jlaustill/gdh-electric/modules/crd-mcp2562/v0.0.1/Picture.png

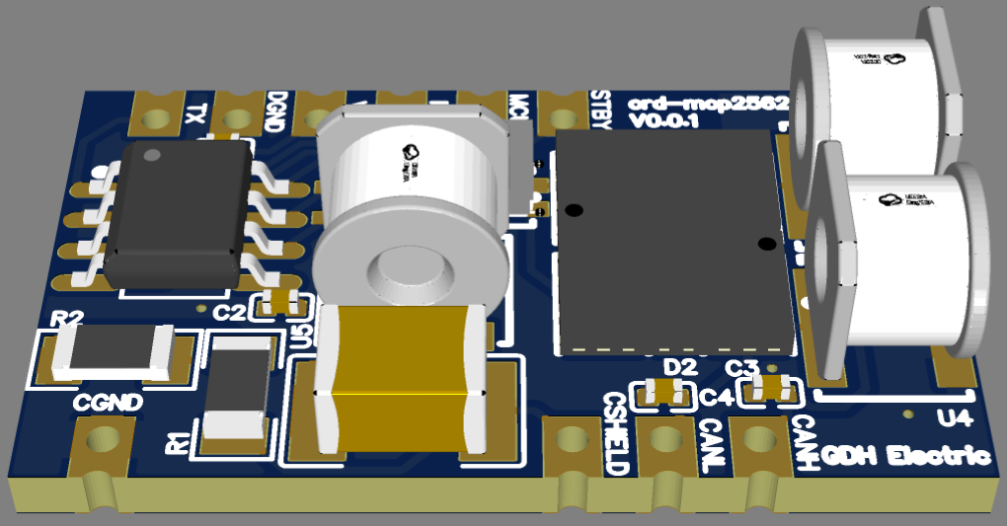
modules/crd-mcp2562/v0.0.1/Picture.png
