jlaustill/gdh-electric/modules/crd-mcp2562/v0.0.1/Schematic.pdf

# CAN-BUS

### CGND

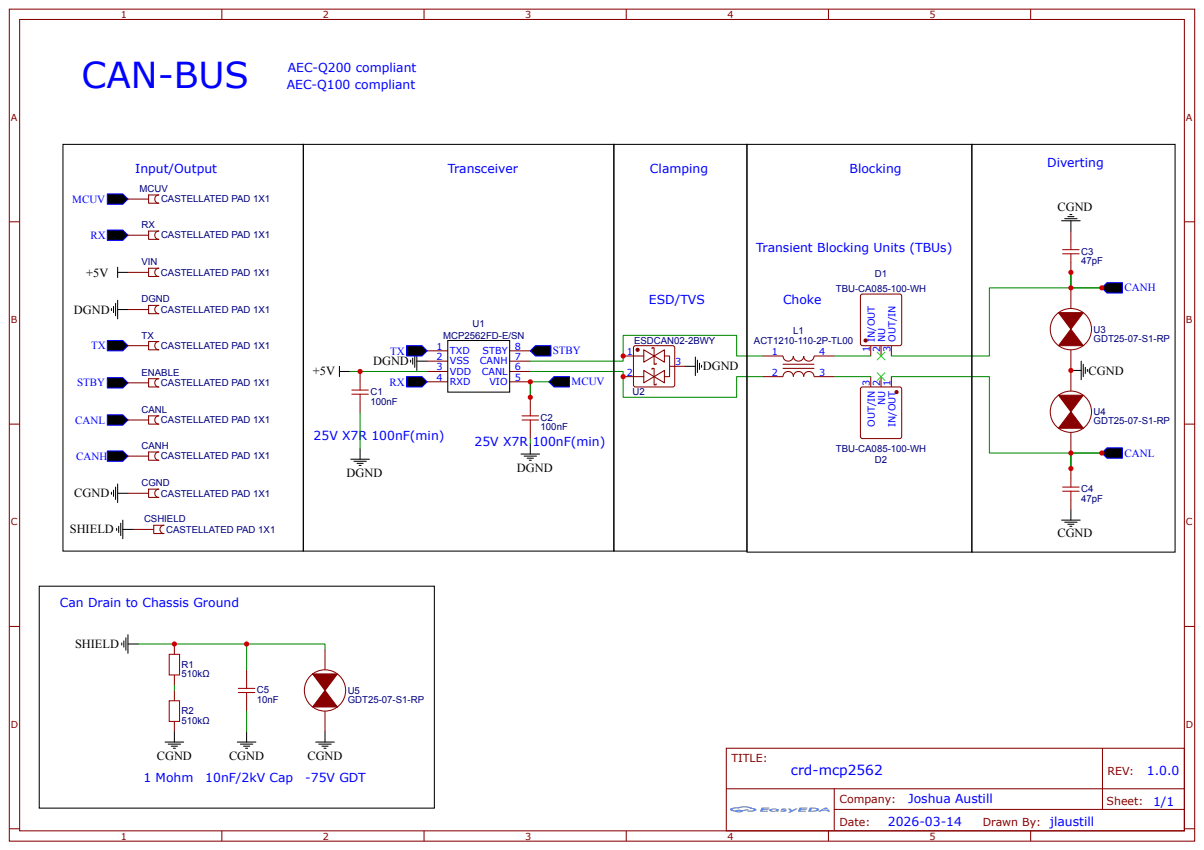
[picture p2: page 1]

Transient Blocking Units (TBUs)

IN/OUT 1 NU 2 OUT/IN 3

Can Drain to Chassis Ground
