jlaustill/gdh-electric/modules/mcu-stm32h725/v0.0.1/mcu-stm32h725.kicad_pcb

## KiCad design modules/mcu-stm32h725/v0.0.1/mcu-stm32h725.kicad_pcb (2026-06-19)

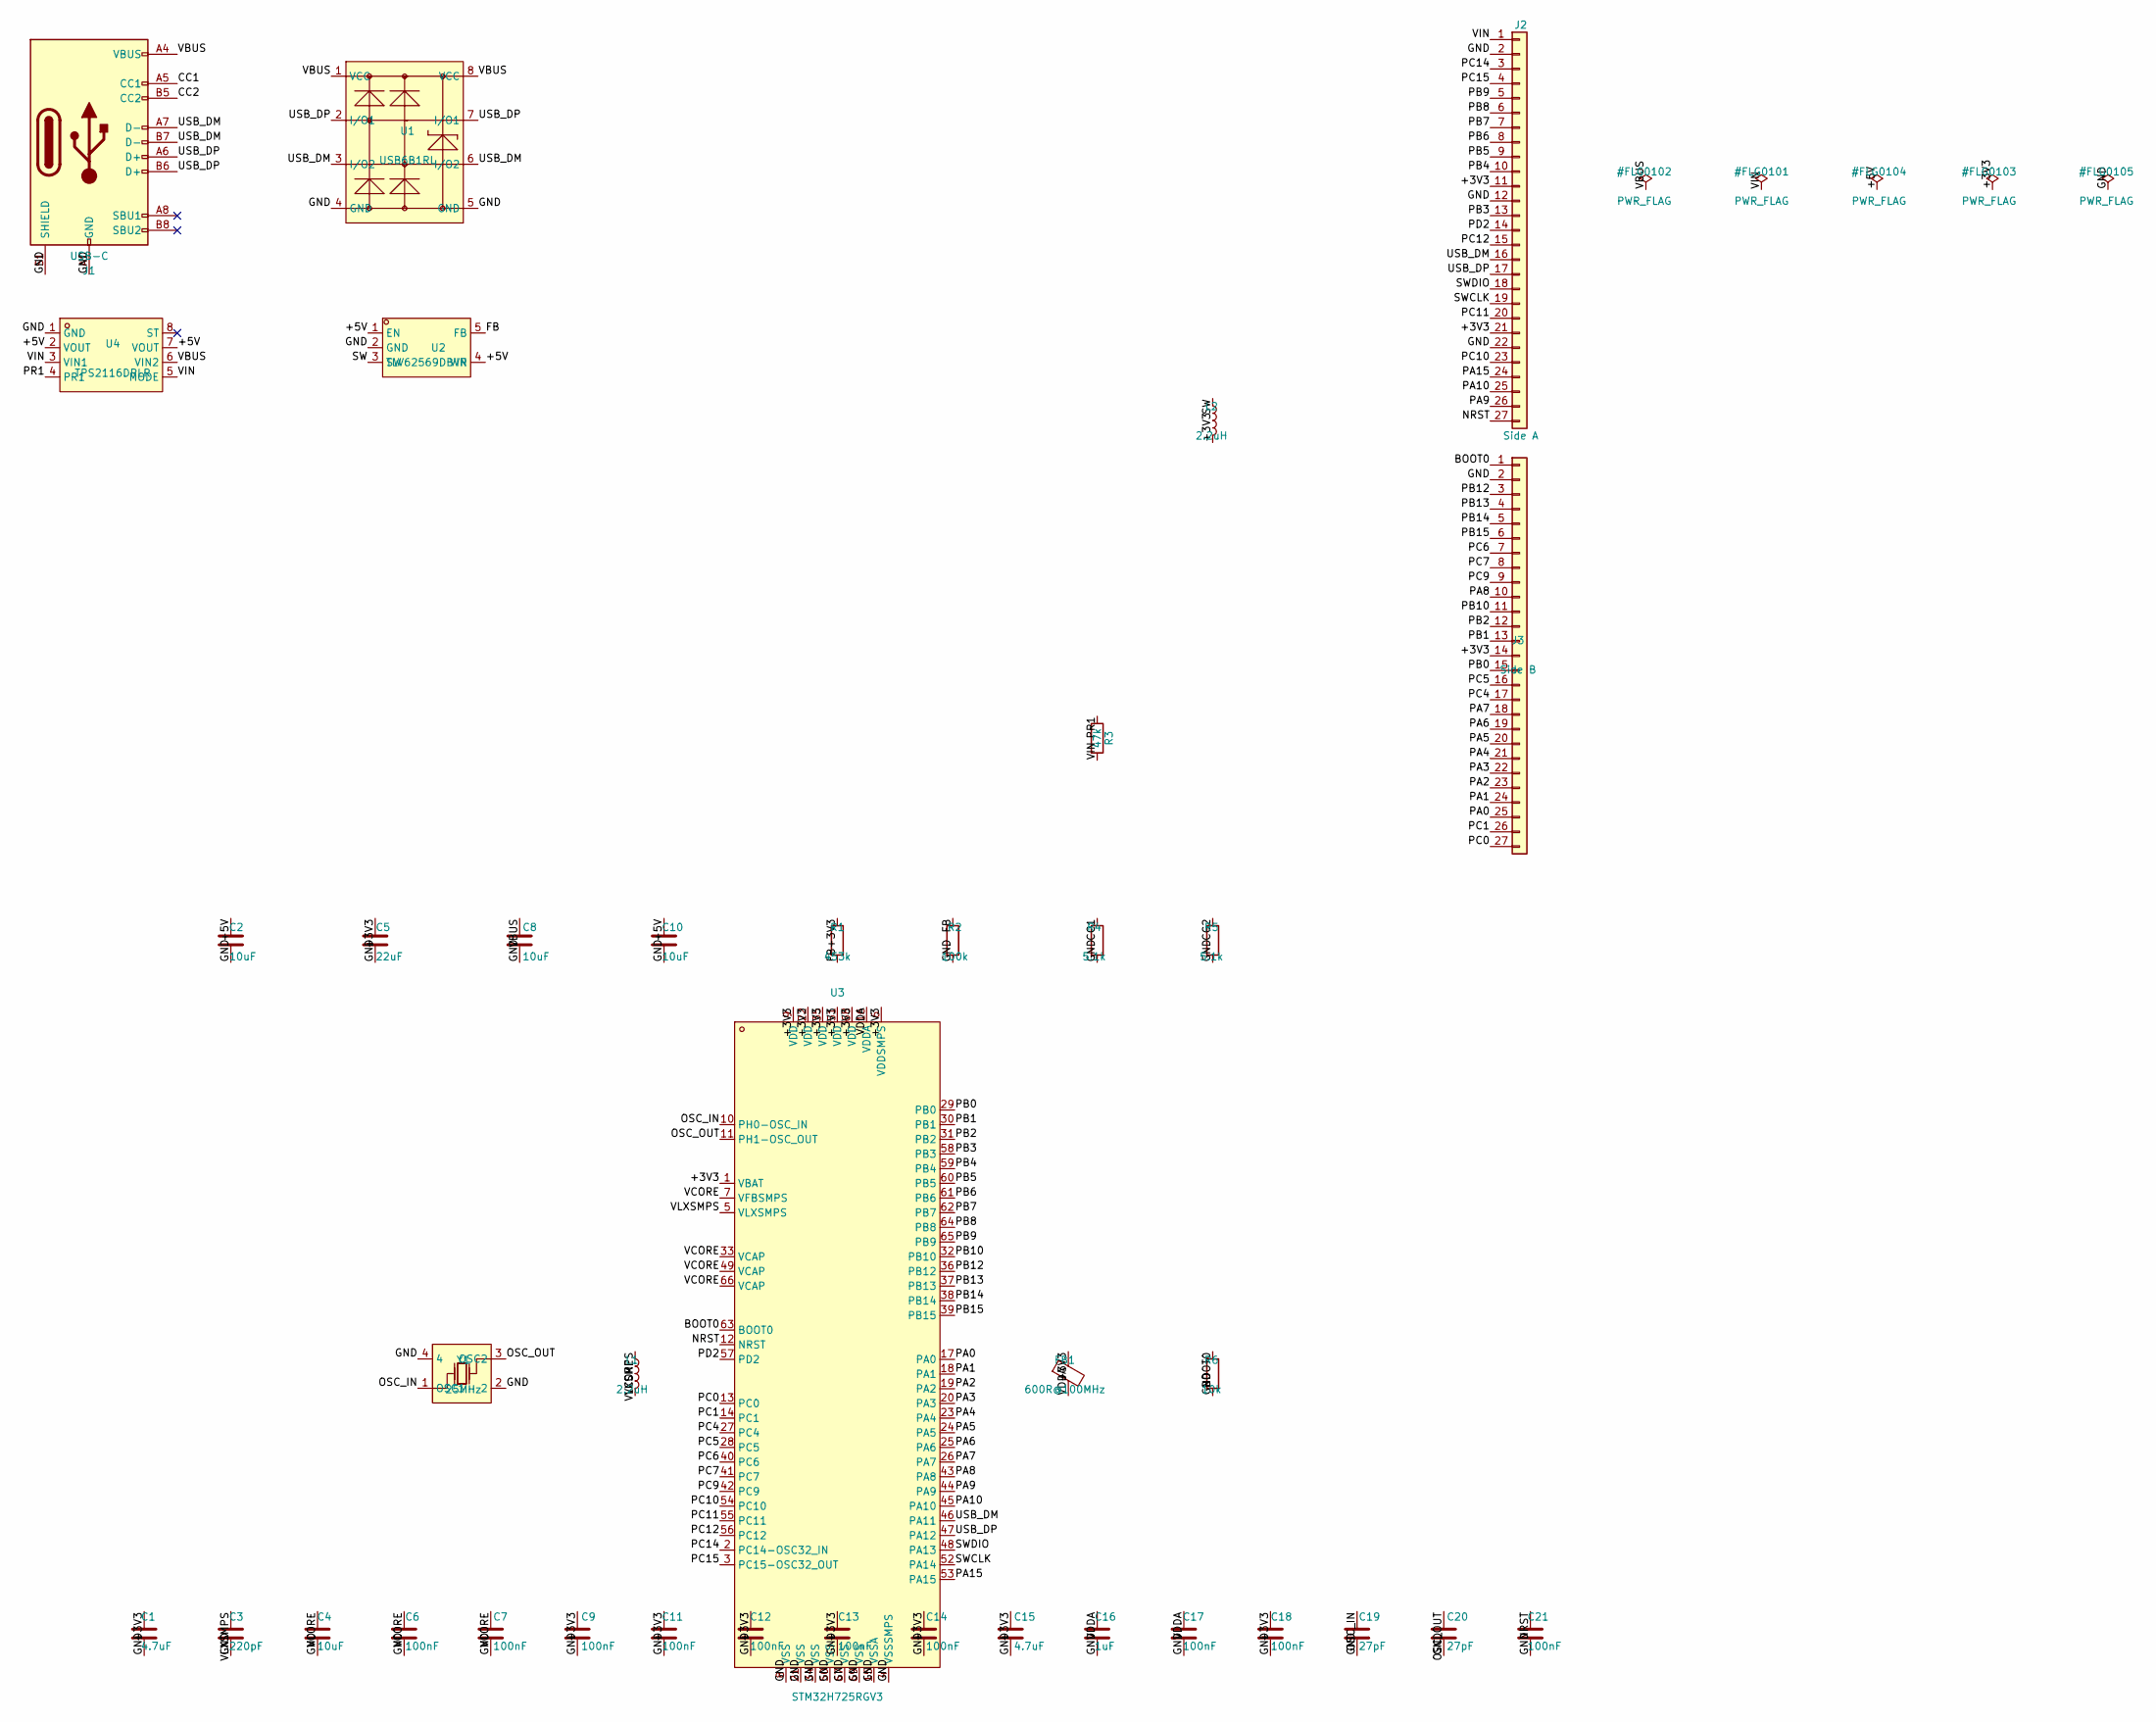
[picture p3: schematic mcu-stm32h725.kicad_sch]

Parts:
C1, C15: 4.7uF; C_0805_2012Metric
C2, C4, C8, C10: 10uF; C_0805_2012Metric
C3: 220pF; C_0402_1005Metric
C5: 22uF; C_0805_2012Metric
C6, C7, C9, C11, C12, C13, C14, C17, C18, C21: 100nF; C_0402_1005Metric
C16: 1uF; C_0805_2012Metric
C19, C20: 27pF; C_0402_1005Metric
FB1: 600R@100MHz; L_0805_2012Metric
J1: USB-C; USB-C_HYP_TC020-24LB02R_C23376530
J2: Side A; Castellation_1x27_P2.54mm_Edge
J3: Side B; Castellation_1x27_P2.54mm_Edge
L1, L2: 2.2uH; L_1210_3225Metric
R1: 453k; R_0603_1608Metric
R2: 100k; R_0603_1608Metric
R3: 47k; R_0603_1608Metric
R4, R5: 5.1k; R_0603_1608Metric
R6: 10k; R_0603_1608Metric
U1: USB6B1RL; SOIC-8_L4.9-W3.9-P1.27-LS6.0-BL
U2: TLV62569DBVR; SOT-23-5_L3.0-W1.7-P0.95-LS2.8-BR
U3: STM32H725RGV3; QFN-68_L8.0-W8.0-P0.40-BL-EP6.4
U4: TPS2116DRLR; SOT-583-8_L2.1-W1.6-P0.50-LS1.6-BL
Y1: 25MHz; CRYSTAL-SMD_4P-L3.2-W2.5-BL

Connections:
/+3V3: C1.1, C5.1, C9.1, C11.1, C12.1, C13.1, C14.1, C15.1, C18.1, FB1.1, J2.11, J2.21, J3.14, L2.2, R1.1, U3.1 (VBAT), U3.6 (VDDSMPS), U3.9 (VDD), U3.22 (VDD), U3.35 (VDD), U3.51 (VDD), U3.68 (VDD)
/+5V: C2.1, C10.1, U2.1 (EN), U2.4 (VIN), U4.2 (VOUT), U4.7 (VOUT)
/BOOT0: J3.1, R6.1, U3.63 (BOOT0)
/CC1: J1.A5 (CC1), R4.1
/CC2: J1.B5 (CC2), R5.1
/FB: R1.2, R2.1, U2.5 (FB)
/GND: C1.2, C2.2, C3.2, C4.2, C5.2, C6.2, C7.2, C8.2, C9.2, C10.2, C11.2, C12.2, C13.2, C14.2, C15.2, C16.2, C17.2, C18.2, C19.2, C20.2, C21.2, J1.A1 (GND), J1.A12 (GND), J1.B1 (GND), J1.B12 (GND), J1.S1 (SHIELD), J2.2, J2.12, J2.22, J3.2, R2.2, R4.2, R5.2, R6.2, U1.4 (GND), U1.5 (GND), U2.2 (GND), U3.4 (VSSSMPS), U3.8 (VSS), U3.15 (VSSA), U3.21 (VSS), U3.34 (VSS), U3.50 (VSS), U3.67 (VSS), U3.69 (VSS), U4.1 (GND), Y1.2, Y1.4
/NRST: C21.1, J2.27, U3.12 (NRST)
/OSC_IN: C19.1, U3.10 (PH0-OSC_IN), Y1.1 (OSC1)
/OSC_OUT: C20.1, U3.11 (PH1-OSC_OUT), Y1.3 (OSC2)
/PA0: J3.25, U3.17 (PA0)
/PA1: J3.24, U3.18 (PA1)
/PA2: J3.23, U3.19 (PA2)
/PA3: J3.22, U3.20 (PA3)
/PA4: J3.21, U3.23 (PA4)
/PA5: J3.20, U3.24 (PA5)
/PA6: J3.19, U3.25 (PA6)
/PA7: J3.18, U3.26 (PA7)
/PA8: J3.10, U3.43 (PA8)
/PA9: J2.26, U3.44 (PA9)
/PA10: J2.25, U3.45 (PA10)
/PA15: J2.24, U3.53 (PA15)
/PB0: J3.15, U3.29 (PB0)
/PB1: J3.13, U3.30 (PB1)
/PB2: J3.12, U3.31 (PB2)
/PB3: J2.13, U3.58 (PB3)
/PB4: J2.10, U3.59 (PB4)
/PB5: J2.9, U3.60 (PB5)
/PB6: J2.8, U3.61 (PB6)
/PB7: J2.7, U3.62 (PB7)
/PB8: J2.6, U3.64 (PB8)
/PB9: J2.5, U3.65 (PB9)
/PB10: J3.11, U3.32 (PB10)
/PB12: J3.3, U3.36 (PB12)
/PB13: J3.4, U3.37 (PB13)
/PB14: J3.5, U3.38 (PB14)
/PB15: J3.6, U3.39 (PB15)
/PC0: J3.27, U3.13 (PC0)
/PC1: J3.26, U3.14 (PC1)
/PC4: J3.17, U3.27 (PC4)
/PC5: J3.16, U3.28 (PC5)
/PC6: J3.7, U3.40 (PC6)
/PC7: J3.8, U3.41 (PC7)
/PC9: J3.9, U3.42 (PC9)
/PC10: J2.23, U3.54 (PC10)
/PC11: J2.20, U3.55 (PC11)
/PC12: J2.15, U3.56 (PC12)
/PC14: J2.3, U3.2 (PC14-OSC32_IN)
/PC15: J2.4, U3.3 (PC15-OSC32_OUT)
/PD2: J2.14, U3.57 (PD2)
/PR1: R3.1, U4.4 (PR1)
/SW: L2.1, U2.3 (SW)
/SWCLK: J2.19, U3.52 (PA14)
/SWDIO: J2.18, U3.48 (PA13)
/USB_DM: J1.A7 (D-), J1.B7 (D-), J2.16, U1.3 (I/O2), U1.6 (I/O2), U3.46 (PA11)
/USB_DP: J1.A6 (D+), J1.B6 (D+), J2.17, U1.2 (I/O1), U1.7 (I/O1), U3.47 (PA12)
/VBUS: C8.1, J1.A4 (VBUS), J1.A9 (VBUS), J1.B4 (VBUS), J1.B9 (VBUS), U1.1 (VCC), U1.8 (VCC), U4.6 (VIN2)
/VCORE: C4.1, C6.1, C7.1, L1.2, U3.7 (VFBSMPS), U3.33 (VCAP), U3.49 (VCAP), U3.66 (VCAP)
/VDDA: C16.1, C17.1, FB1.2, U3.16 (VDDA)
/VIN: J2.1, R3.2, U4.3 (VIN1), U4.5 (MODE)
/VLXSMPS: C3.1, L1.1, U3.5 (VLXSMPS)

Board: 4 copper layers, 38 parts (0 on the bottom side), 61 nets, no tracks yet.
