jlaustill/gdh-electric/(commit log)

2026-06-01 Add crd-mcp2562 module datasheets, clean BOM, and CC0 license
    - Clean BOM.csv: re-encode UTF-16 -> UTF-8, drop the castellated-pad
    footprint (not an orderable/placeable part), fill the TBU's empty
    Manufacturer Part field, and add a Datasheet column linking each
    part to its local PDF.
    - Add datasheets/ with all 9 orderable components (sourced from LCSC;
    the Kyocera AVX 47pF cap from Kyocera AVX directly).
    - Add CC0 1.0 Universal LICENSE (public-domain dedication).
    [BOM.csv, PickAndPlace.csv]
2026-06-01 Clean PickAndPlace.csv: re-encode UTF-8, drop castellated pads
    Re-encode UTF-16 -> UTF-8 and remove the 10 CASTELLATED_PAD rows, which
    are board-edge copper, not machine-placeable parts. Leaves the 15
    placeable components, consistent with the cleaned BOM.
    [PickAndPlace.csv]
2026-06-01 Add project CLAUDE.md with module/EasyEDA/datasheet workflow
    Captures the recurring conventions for this hardware module library:
    EasyEDA UTF-16 export handling, LCSC datasheet sourcing recipe, BOM/
    PickAndPlace conventions (exclude castellated pads), datasheet naming,
    and CC0 licensing default.
2026-06-01 Add GDH Electric module specification
    Establish spec/README.md as the living module standard, in two layers:
    - Philosophy: mission, right-to-repair/perpetuity, breadboard-compatible
    + reusability (castellated edges over 2.54mm pins to ease desoldering
    and reduce landfill waste), robust-by-default (-40C..125C minimum,
    AEC-Q200 parts), and the chip-driver-vs-MCU-peripheral library policy.
    - Conformance: module layout (version silkscreened on PCB), required
    deliverables, BOM/PnP/datasheet conventions, CC0 licensing, and
    reserved sections for future revisions.
    Remove the empty versioned v0.1.md stub; the spec is a living document
    with git as its changelog.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
2026-06-01 Switch crd-mcp2562 schematic to SVG; regenerate clean PDF
    EasyEDA's direct PDF export is low-fidelity (overlapping/mangled labels).
    Add Schematic.svg as the primary, browser-renderable, diff-friendly
    artifact and regenerate Schematic.pdf from it (crisp vector via cairo/
    inkscape). Updated schematic also fixes the GDT annotation (75 V) and
    adds clamp/block/divert functional blocks.
    - spec: required deliverables now list Schematic.svg (primary) +
    Schematic.pdf (generated from the SVG).
    - CLAUDE.md: document the SVG-export + convert-to-PDF workflow.
2026-06-01 Add crd-mcp2562 board images (top view + 3D render)
    - PCB-Top.svg: top-layer layout/silk view (added a dark background so the
    white silkscreen labels stay readable in GitHub light *and* dark mode).
    - Picture.png: 3D photo-realistic render; placeholder to be swapped for a
    real assembled-board photo later. Silk now reads STBY (pin renamed to
    match the schematic, not just the net label).
2026-06-03 Fold design doctrine into the spec
    Capture the design philosophy worked out in practice:
    - North star: design against the landfill (salvage in 50 years), explicitly
    rejecting minimum-viable/throwaway hardware.
    - Robust by default: protection is "silently omittable" so it must be baked
    in; litmus test — reject a design rule that would strip protection.
    - New "Module + carrier architecture" section: lean rugged core + stackable
    (ESP32-style) carriers; decide on-module vs carrier by "will a future
    integrator be forced to supply it, or is it silently omittable?"; cost
    rationale for keeping the core lean.
    - Seed the reserved "Electrical & protection minimums" with that rule.
    Co-Autho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
2026-06-03 Update CLAUDE.md with session learnings
    - Deliverables now lead with Schematic.svg (alongside the PDF).
    - Point to spec/README.md as the home for design doctrine + conformance.
    - Document the EasyEDA layout-SVG gotcha (transparent bg + white silk →
    invisible on GitHub light mode; inject a dark background rect).
    - Add a Board images section (Picture.png / PCB-Top.svg; 3D/STL dead-end).
2026-06-16 Add protect-12v module design spec (draft)
    Rugged 12V power-input protection front-end (Stage-1 lift of OCT); locked vs open decisions per spec/README.md.
2026-06-16 Add MCU selection decision: STM32H725RGV3 (rugged general-purpose brain)
    Selects STM32H725 (Cortex-M7, 3x FDCAN, -40/+125C ambient) in the VFQFPN-68 package (STM32H725RGV3, LCSC C5271074) for a planned general-purpose rugged controller module. Records the 11-part evaluation, the AEC-Q100-vs-temperature-range finding, rejected alternatives, open items, and files the DS13311 datasheet.
2026-06-17 Start mcu-stm32h725 module: folder, datasheet, pin plan
    Create modules/mcu-stm32h725/v0.0.1/ for the universal STM32H725RGV3 controller devboard. Move the datasheet into the module datasheets/ folder and add pinmap.md (locked decisions: 2.54mm pitch, 54 castellations, USB-FS DFU, power-path ORing, >=500mA 3V3, balanced 3V3/GND pairs, HSE crystal; 54-pad budget). Update datasheet path refs in the selection doc.
2026-06-17 Add KiCad symbol/footprint/3D libraries for mcu-stm32h725
    Generated from LCSC codes via easyeda2kicad: STM32H725RGV3 (C5271074), TLV62569DBVR buck (C141836), TPS2116DRLR power-mux (C3235557). 3/3 symbols + footprints (incl. the QFN-68 8x8 0.4mm), 2/3 3D models (MCU has none in EasyEDA).
2026-06-17 Add KiCad project scaffolding for mcu-stm32h725
    Project file + project-local symbol/footprint library tables pointing at the easyeda2kicad libs, so the 3 parts are pre-registered on open (no manual add-library step).
2026-06-17 Add USB6B1RL + USB-C connector to mcu-stm32h725 KiCad lib
    USB6B1RL USB-port protection (C10508, covers VBUS + D+/D-) and TYPE-C-31-M-12 USB-C 2.0 receptacle (C165948), via easyeda2kicad with symbol + footprint + 3D. Library now holds all 5 custom parts (MCU, buck, OR-mux, USB protection, USB-C).
2026-06-17 Swap USB-C to HYP TC020-24LB02R (+165C); add -55/+125C crystal
    Crystal: ECS-250-20-33-DU-TR (C435188, -55/+125C, 25MHz/20pF) via easyeda2kicad.
    USB-C: HYP TC020-24LB02R-C3 (C23376530, -25/+165C) - no EasyEDA data, so footprint+3D sourced from KiCad's vetted bundled HRO_TYPE-C-31-M-12 (verified same canonical 16-pad sink land pattern); symbol = KiCad global USB_C_Receptacle. Removed superseded TYPE-C-31-M-12 (C165948, +80C only). Establishes the alternate footprint-sourcing path: LCSC availability is the only hard part requirement.
2026-06-17 Add power-block schematic for mcu-stm32h725
    USB-C (J1) -> USB6B1RL VBUS/D+- protection -> TPS2116 Vin-priority OR-mux -> TLV62569 buck -> 3.3V. 14 parts, 12 nets, wired via net labels (built live through the KiCad MCP over IPC). TPS2116 priority: VIN1=VIN, VIN2=VBUS, MODE->VIN1, PR1->47k->VIN1. Also gitignore KiCad transient files (.kicad_prl/backups/lock).
    [mcu-stm32h725.kicad_sch]
2026-06-17 Complete mcu-stm32h725 schematic: MCU core + full GPIO breakout (ERC 0 errors)
    Direct-SMPS power tree (VDDSMPS/VLXSMPS+L2/VFBSMPS=VCORE per DS13311 Table 16), full VDD/VCAP/VDDA decoupling, HSE crystal, BOOT0/NRST, USB to PA11/12. All 44 GPIO broken out by RAW pin name (no aliasing) to edge connectors J2 (Side A) + J3 (Side B). PWR_FLAGs + no-connects on unused USB-C SS/SBU + TPS2116 ST. 4-layer PCB chosen. ERC: 0 errors, 130 benign easyeda-symbol warnings.
    [mcu-stm32h725.kicad_sch]
2026-06-18 Add PCB: 4-layer outline (68.6x18mm) + castellated edges for mcu-stm32h725
    F8-imported netlist (37 footprints, 62 nets verified). Board outline drawn to size on Edge.Cuts; J2/J3 castellation strips (27 plated half-holes @ 2.54mm) on the long edges, pads bisected by the cut. Custom Castellation_1x27_P2.54mm_Edge footprint. Edited .kicad_pcb directly (MCP board write/save broken in this env). NOTE: board refs re-annotated by F8 (!= schematic) - reconcile via back-annotation before deliverables.
    [mcu-stm32h725.kicad_pcb, mcu-stm32h725.kicad_sch]
2026-06-18 Lay out mcu-stm32h725 PCB: centered placement + 4-layer planes + optimal pin map
    All 38 footprints placed (MCU centered for balanced GPIO fan-out; power block by USB-C; decoupling ringing the MCU; bulk caps right). GND plane (In1.Cu) + +3V3 plane (In2.Cu) zones added + filled. Castellation pads marked pad_prop_castellated in board + library (clears edge-clearance DRC). Schematic fixes: L1 footprint L_1210_3225Metric; USB-C symbol -> USB_C_Receptacle_USB2.0_16P to match the 16-pad footprint; J1 instance annotation repaired. Castellation pin map is crossing-free per edge and optimal for the centered MCU (~656mm ratsnest). DRC: 0 electrical violations (only unrouted nets + cosmetic silk/fill re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
    [mcu-stm32h725.kicad_pcb, mcu-stm32h725.kicad_sch]
2026-06-18 Add placement-criticality guide for mcu-stm32h725
    Tiered reference (critical/important/relaxed/power-block) for how close each support part must sit to its pin, with the loop-inductance rationale + routing notes (4-layer stackup, via-to-plane, SMPS loop priority). Board-side reference designators.
2026-06-18 Document KiCad-module workflow + gotchas in CLAUDE.md
    mcu-stm32h725 is KiCad 9 (not EasyEDA); MCP board writes unreliable (edit .kicad_pcb directly, pcbnew closed); pcbnew caches schematic at open; F8 re-annotates refs; castellated module keeps B.Cu component-free.
2026-06-18 WIP: hand placement of mcu-stm32h725 (tight, pre-fan-out)
    User's hand-arranged layout — good relative placement, tightly squished with sub-mm overlaps to be fanned out next. Tighten .bak* gitignore to catch backup variants.
    [mcu-stm32h725.kicad_pcb]
2026-06-19 Shrink mcu-stm32h725 reference labels to 0.8mm (JLCPCB silk minimum)
    Hand-placement at 1.0mm silk left reference designators oversized and
    overlapping on the tight 68.6x18mm layout. Set all 38 component reference
    designators to 0.8mm height / 0.15mm thickness — JLCPCB's recommended
    silkscreen minimum — which declutters the board while staying fab-safe.
    Value/Datasheet/Description fab-layer fields left unchanged.
    [mcu-stm32h725.kicad_pcb]
2026-06-19 Reorganize mcu-stm32h725 schematic
    In-progress schematic organizing; KiCad 9 re-save also expands the file
    from minified single-line to standard multi-line sexp format.
    [mcu-stm32h725.kicad_sch]
2026-07-23 Add design spec: mcu-imxrt1062 rugged high-temp Teensy module
    Replaces mcu-stm32h725 as GDH's general-purpose brain. A rugged,
    high-temperature, Teensy-4.x-ecosystem-compatible castellated module
    built on the industrial-grade i.MXRT1062, using PJRC's pre-programmed
    bootloader chip (mail-in assembly) so no from-scratch firmware is needed.
    Key decisions captured: industrial C-grade MCU, 16MB flash + 8MB PSRAM,
    dual-access USB1 (on-module USB-C + castellated) for always-reprogrammable-
    when-sealed, voltage-agnostic clean-5V input (carrier owns the power domain),
    and a free contiguous 16-bit parallel port on GPIO6[31:16] that the fat
    memory config leaves untouched.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
2026-07-23 Add Foundation implementation plan for mcu-imxrt1062
    Milestone 1 of 3 (Foundation -> Schematic -> Layout/outputs): scaffold the
    KiCad 9 module on the reused 54-castellation outline, source every part
    (LCSC code + symbol/footprint/3D + verified datasheet), and author the
    definitive 54-pin castellation map. Adapts the software-oriented plan
    format to the KiCad hardware workflow (ERC/DRC/LCSC/datasheet gates instead
    of pytest).
2026-07-23 scaffold mcu-imxrt1062 module on the 54-castellation outline
    Copy the mcu-stm32h725 v0.0.1 board, strip all 36 STM32 part footprints
    (string-aware sexp surgery), keeping only the two Castellation_1x27 strips
    (54 castellated pads) and the Edge.Cuts outline. Self-contained new project:
    own footprint library (castellation strip), empty symbol lib, repointed
    lib-tables, project file, blank KiCad 9.0.9 schematic, CC0 license.
    Verified: 54 castellated pads, balanced parens, ERC clean.
    [mcu-imxrt1062.kicad_pcb, mcu-imxrt1062.kicad_sch]
2026-07-23 lock mcu-imxrt1062 BOM skeleton with verified LCSC codes
    12 orderable parts verified against the LCSC detail API. High-temp MCU
    (MIMXRT1062CVJ5B) kept and reclassified as distributor-sourced/mail-in
    (LCSC trickle 35, Digikey 350 Production) alongside the PJRC bootloader.
    Power mux adopted as TPS2116DRLR (SOT-583) since VSSOP-8 isn't stocked.
2026-07-23 source mcu-imxrt1062 MCU + flash + PSRAM (libs + datasheets)
    easyeda2kicad symbol/footprint/3D for U1 MIMXRT1062CVJ5B (BGA-196, 196 pads
    verified), U3 W25Q128JVSIQ (SOIC-8), U4 APS6404L-3SQR-ZR (USON-8). Datasheets
    verified (%PDF + part number): W25Q128 (LCSC), MIMXRT1062 (NXP industrial
    IMXRT1060IEC via Wayback), APS6404L (AP Memory via Wayback). U4 STEP 3D 404'd
    at LCSC; WRL model present.
2026-07-23 source mcu-imxrt1062 USB1 subsystem (USB-C, HS mux, ESD)
    easyeda2kicad libs + verified datasheets for J1 TYPE-C-31-M-12 (16-pin USB2.0
    receptacle), U5 TS3USB221ARSER (UQFN-10 HS 2:1 mux), D1 USBLC6-2SC6 (SOT-23-6
    ESD). All datasheets %PDF + part-number verified.
2026-07-23 source mcu-imxrt1062 power, clock, and protection parts
    easyeda2kicad libs + datasheets for U6 TPS2116DRLR (SOT-583), U7 TLV62569DBVR
    (SOT-23-5 buck), L1 ZNR3015ST2R2M (2.2uH), Y1 X322524MSB4SI (24MHz), Y2
    Q13FC1350000400 (32.768kHz RTC), D2 ESD5B5.0ST1G (SOD-523 VBUS TVS). All
    datasheets %PDF-verified. 12 orderable parts now fully sourced.
2026-07-23 author definitive 54-pin castellation map for mcu-imxrt1062
    Authoritative Teensy-4.1-pin -> RT1062-pad -> GPIO.bit -> BGA-ball map for all
    42 I/O (from the NXP industrial datasheet ball map + PJRC core_pins.h), plus
    USB1 D+/D-, Program (bootloader net), Reset (POR_B), power, and 6 GND. The
    16-bit GPIO6[31:16] parallel window is placed contiguous + in bit-order on
    Cast 8-23, GND-flanked (7,24) for SSO return. Includes supply/special ball
    table for schematic and Program/Reset semantics. Validated: 54 unique
    castellations, all pins present, window contiguous, no duplicate balls.
2026-07-23 mcu-imxrt1062 foundation gate: sourcing + pinmap verified
    All 12 orderable parts in stock and fully sourced (symbols/footprints/3D/
    datasheets); pinmap validated. Two carry-forwards to Plan 2: customer-supplied
    U2 MKL02 bootloader footprint/symbol, and U4's cosmetic STEP model. Foundation
    milestone complete. (report named foundation-report.md; report.txt is gitignored.)
